ITDiscovery/AVR128PS2Keyboard/README.md

# AVR128PS2Keyboard
This project started as a way to attach a USB Keyboard to a retro computer, the ZX-81. The schematic and board will
accomodate most any retro PC that uses a matrix. It has the ability for both Shift, CTRL, ALT and one other "function key". The board is an extension of the AVR128DB28 Breakout board, so I've included the ability to get at all the ports this device has. This board was not designed to have the fab part out the board for you. I could have done a surface mount board that would be pretty tiny if that were the case, but there's no demand for it. I see this board to assist in troubleshooting, and for demos and museums to extend functionality to users without risking the original keyboard. I have had difficulty in finding keyboards that work with the PS2Keyboard library also.

Design Goals:
1. USB to ZX-81 (done)
1. USB to ZX Spectrum (or Harlequin) (done)
1. USB to Dragon (done on CoCo2)
1. USB to Color Computer 2/3 (done on CoCo2)
1. USB to Model 1/2/3/4/4P/16/6000
1. USB to Commodore VIC20 (done) /C64/PET
1. Classic MacIntosh (M0110 keyboard) via the J9 Connector, and Mouse via J6 Connector. (https://github.com/altercation/tmk_firrmware_hhkb_teensy2/blob/master/protocol/m0110.c) -Done: Needs more work, and I need to correct some issues with my MacClassicPlus 1Mb. This code base will be standalone...how this old Mac handles keys is different from the other retro computers.
1. Have it so that you can select or change on the fly which system you are emulating (done)
1. Have it store a default emulation in EEPROM (done)
1. Provide the ability to do a reset/restore (Using 4Z gate, Pin 7 and 8 on H6). (done)
1. Have it display via keyboard led which emulation it's doing (keyboard.setLEDs seems to be broken, next board can have LEDs added)
1. Provide a serial connection or a Composite TV, so a quicky dumb terminal (combines a couple of projects)
1. Move the lookup tables to Flash (PROGMEM done)

I didn't need to re-write the PS2Advanced Library. After a couple of iterations of DXCore updates, it started working. A guess is that it was a problem with attachInterupt...which if you change the setting of, the library doesn't work at all.

Here's Ben Eater's description of how the Keyboard works. All that is done via the PSAdvanced library.
https://www.youtube.com/watch?v=7aXbh9VUB3U

Level of knowledge/skills required to complete this project:
- Ordering boards from a PCB Prototype shop (I use JCLPCB, so this is a shout out to them.)
- The code is written for Arudino and requires the DXCore library (https://github.com/SpenceKonde/DxCore). You must understand how to program Arduinos, how to add libraries (PS2Advanced Libary is at https://github.com/techpaul/PS2KeyAdvanced) and boards. This is a two step process, you must use the UDPI port to load the bootloader and then the Serial Port to load the code via an FTDI connector.
- Soldering level is moderate. The AVR (which is a surface mount component) is not difficult, it just takes a bit of practice, use flux and small diameter solder. This doesn't use the through hole AVR because those are made of unobtainium. I've recently changed the Gerber on the board to show the values of the parts instead of the part numbers, and am including a BOM from Digikey below. 
- Understanding of the system your adding this wedge to. 

Quick notes:
- 5 boards is 8.50....(presuming it ships, I just combined this with another order and got 5 boards for 2 dollars).
- Maybe $15 for the rest of the components. You'll probably want to just build out all 5. The AVR128DB28 is $1.5 and the logic chips are $0.70 apiece, some resistors and caps. If you don't have anything, buy assortments from Amazon, except for C3. The USB connector is also pricey.
- Never tie the 5v of your target computer and use the FTDI connector at the same time.

Specific support for the various lines have been broken out:
- [Sinclair](https://github.com/ITDiscovery/AVR128PS2Keyboard/blob/main/Sinclair.md) full support of the ZX-80/81 and the Spectrum.
- [Tandy/RadioShack](https://github.com/ITDiscovery/AVR128PS2Keyboard/blob/main/TRS.md) untested code for the Color Computer and Model 3.
- [Commodore](https://github.com/ITDiscovery/AVR128PS2Keyboard/blob/main/Commodore.md) untested code for the C64, and VIC20.

Mux Code is driven by the follwing:

| Connection | Bits  7/6 | Bits 5/4/3 | Bits 2/1/0 |
| - | - | - | - |
| H3-1 | XX | XXX | 000 | 
| H3-2 | XX | XXX | 001 | 
| H3-3 | XX | XXX | 010 | 
| H3-4 | XX | XXX | 011 | 
| H3-5 | XX | XXX | 100 | 
| H3-6 | XX | XXX | 101 | 
| H3-7 | XX | XXX | 110 | 
| H3-8 | XX | XXX | 111 | 
| H4-1 | XX | 000 | XXX | 
| H4-2 | XX | 001 | XXX | 
| H4-3 | XX | 010 | XXX | 
| H4-4 | XX | 011 | XXX | 
| H4-5 | XX | 100 | XXX | 
| H4-6 | XX | 101 | XXX | 
| H4-7 | XX | 110 | XXX | 
| H4-8 | XX | 111 | XXX | 
| No-Shift| 00 | XXX | XXX |
| H6-1/2 | 01 | XXX | XXX |
| H6-3/4 | 10 | XXX | XXX |
| H6-5/6 | 11 | XXX | XXX |

A reset or other switched line (Restore on Commodore for instance) can be
connected to pins H6-7 and H6-8 where the code will perform make contact for 100mSec
when the Pause/Break (Code 6) is typed. A handy ground pin at H5-1 can be used to with a
dropping resistor to H6-8 for a nice reset button.

Connection to the Mac Classic (This is a separate code base):
1. J9-1(Gnd) to H5-1 
1. J9-2(Clk) to H5-4
1. J9-3(Data) to H5-3
1. J9-4(+5v) to H5-2 (Don't populate R4 or R5)
1. J6-1(Gnd) H7-1
1. J6-2(+5V) H7-2
1. J6-3 N/C
1. J6-4(X2) H7-3
1. J6-5(X1) H7-4
1. J6-6 N/C
1. J6-7(SW-) to U4-12
1. J6-8(Y2) to H7-5
1. J6-9(Y1) to H7-6

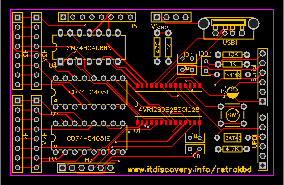
[picture p1: PCB_Retro-Keyboard-from-USB.png]
Board


Bill of Materials (see https://www.digikey.com/en/mylists/list/SCZP9ZUCUN):

- H3A,H4A,H6,H3,H4: HDR-TH_8P-P2.54
- H7:	HDR-TH_6P-P2.54
- U1: AVR128DB28SOIC28
- U2,U3: CD74HCT4051E
- U4: SN74HCT4066N
- C1,C5: 	1uF Capacitor (noise filter)
- C2,C6:  10nF (0.01uF) Capacitor
- C7: 100nf (.1uF) Capacitor
- C3: 4.7uF Electorlytic Capacitor
- D1,D2: 1N4148 Diode (D2 as a BAT43 schotky will work better in some UPDI cases).
- H1,H2: HDR-TH_6P-P2.54
- Optional H5: HDR-TH_4P-P2.54
- R1: 10K 1/4W
- R2: 4.7K 1/4W
- Optional R4: 470 1/4W
- Optional R5: 1K 1/4W
- R6: 1K
- SW1: Button-6x6x6mm
- USB1: USB-A-TH_USB-M-18
