ITDiscovery/AVR128PS2Keyboard/TRS.md

# TRS (Tandy Radio Shack) Color Computer 1,2,3 and Model 1,2,3,4,4P,12,6000 (Untested)
This file contains the connection and keyboard info for the Color Computer 2/3 and Model 3. This code has not been tested.

## Color Computer 2/3
The CoCo3 adds ALT, CTRL for more keymapping, and an F1 and F2 key. It's likely the CoCo3 Keymap will work on a CoCo2.

### Connections
Connect on the board:
1. H4A-8 to H6-1 (Shift)
1. H3A-7 to H6-2
1. H6-2 to H6-3 (CTRL)
1. H4A-5 to H6-4
1. H6-3 to H6-5 (ALT)
1. H4A-4 to H6-6

Connect the board to the Color Computer 2:
1. H7-5 to +5V
1. H7-6 to Gnd
1. H3-1 to J5-1 (R1/Pin 2/PA0)
1. H3-2 to J5-2 (R2/Pin 3/PA1)
1. H3-3 to J5-4 (R3/Pin 4/PA2)
1. H3-4 to J5-5 (R4/Pin 5/PA3)
1. H3-5 to J5-6 (R5/Pin 6/PA4)
1. H3-6 to J5-7 (R6/Pin 7/PA5)
1. H3-7 to J5-8 (R7/Pin 8/PA6)
1. H4-1 to J5-9 (C9/Pin 9/PB0)
1. H4-2 to J5-10 (C10/Pin 10/PB1)
1. H4-3 to J5-11 (C11/Pin 11/PB2)
1. H4-4 to J5-12 (C12/Pin 12/PB3)
1. H4-5 to J5-13 (C13/Pin 13/PB4)
1. H4-6 to J5-14 (C14/Pin 14/PB5)
1. H4-7 to J5-15 (C15/Pin 15/PB6)
1. H4-8 to J5-16 (C16/Pin 16/PB7)

Connect the board to the Dragon64:
1. H7-5 to +5V
1. H7-6 to PL1-3 (Gnd)
1. H3-1 to PL1-4 (KR2)
1. H3-2 to PL1-5 (KR3)
1. H3-3 to PL1-6 (KR4)
1. H3-4 to PL1-7 (KR5)
1. H3-5 to PL1-1 (KR0)
1. H3-6 to PL1-1 (KR1)
1. H3-7 to PL1-8 (KR6)
1. H4-1 to PL1-9 (KC0) 
1. H4-2 to PL1-10 (KC1)
1. H4-3 to PL1-11 (KC2)
1. H4-4 to PL1-12 (KC3)
1. H4-5 to PL1-13 (KC4)
1. H4-6 to PL1-14 (KC5)
1. H4-7 to PL1-15 (KC6)
1. H4-8 to PL1-16 (KC7)

**Note: PA7 goes to the DAC (U3)

### Keychart

| Key | 1 | 2 | 3 | 4 | 5 | 6 | 7 | 8 | 9 | 0 |
| - | - | - | - | - | - | - | - | - | - | - |
| USB Code| 49 | 50 | 51 | 52 | 53 | 54 | 55 | 56 | 57 | 48 | 
| Row/Col | R5C10 | R5C11 | R5C12 | R5C13 | R5C14 | R5C15 | R5C16 | R6C9 | R6C10 | R5C9 |
| Mux Code| B001100 | B010100 | B011100 | B100100 | B101100 | B110100 | B111100 | B000101 | B001101 | B000100 |

| Key | Q | W | E | R | T | Y | U | I | O | P |
| - | - | - | - | - | - | - | - | - | - | - |
| USB Code| 81 | 87 | 69 | 82 | 84 | 89 | 85 | 73 | 79 | 80 | 
| Row/Col | R3C10 | R3C16 | R1C14  | R3C11 | R3C13 | R4C10 | R3C14 | R2C10 | R2C16 | R3C9 |
| Mux Code| B001010 | B111010 | B101000| B010010 | B100010 | B001011 | B101010 | B001001 | B111001 | B000010 |

| Key | A | S | D | F | G | H | J | K | L | ENTER |
| - | - | - | - | - | - | - | - | - | - | - |
| USB Code| 65 | 83 | 68 | 70 | 71 | 72 | 74 | 75 | 76 | 286 | 
| Row/Col | R1C10 | R3C12 | R1C13 | R1C15 | R1C16 | R2C9 | R2C11 | R2C12 | R2C13 | R7C9 |
| Mux Code| B001000 | B011010 | B100000 | B110000 | B111000 | B000001 | B010001 | B011001 | B100001 | B000110 |

| Key | Z | X | C | V | B | N | M | . | SPACE | @ |
| - | - | - | - | - | - | - | - | - | - | - |
| USB Code| 90 | 88 | 67 | 86 | 66 | 78 | 77 | 61 | 287 | 16434 |
| Row/Col | R4C11 | R4C9 | R1C12 | R3C15 | R1C11 | R2C15 | R2C14 | R6C15 | R4C16 | R1C9 |
| Mux Code| B010011 | B000011 | B011000 | B110010 | B010000 | B110001 | B101001 | B110101 | B111011 | B000000 |

| Key | U-Arrow | D-Arrow | L-Arrow | R-Arrow | : | ; | , | - | . | / | 
| - | - | - | - | - | - | - | - | - | - | - |
| USB Code| 279 | 280 | 277 | 278 | 16475 | 91 | 59 | 60 | 61 | 62 | 
| Row/Col | R4C12 | R4C13 | R4C14 | R4C15 | R6C11 | R6C12 | R6C13 | R6C14 | R6C15 | R6C16 |
| Mux Code| B011011 | B100011 | B101011 | B110011 | B010101 | B011101 | B100101 | B101101 | B110101 | B111101 |

| Key | Clear | Break | ALT | CTRL | F1 | F2 | L - Shift | R - Shift |
| - | - | - | - | - | - | - | - | - |
| USB Code| 284 | 283 |  | 8456 | 16646 | 16647 | 353 | 354 | 16646 | 16647 |
| Row/Col | R7C10 | R7C11 | R7C16 | R7C16 | Shift & R6C11 | Shift & R6C12 | Shift & R6C13 | Shift & R6C14 | Shift & R6C15 | Shift & R6C16 |
| Mux Code| B001110 | B010110 | B111110 | B111110 | B1010101 | B1011101 | B1100101 | B1101101 | B1110101 | B1111101 |

```
  {
    //Color Computer 2,3 - Tabletop = 177
    {2,49,B001100},{2,50,B010100},{2,51,B011100},{2,52,B100100},{2,53,B101100},{2,54,B110100},{2,55,B100111},{2,56,B000101},{2,57,B001101},{2,48,B000100},
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
1. H3-7 to J1-7 (R7/A6)
1. H3-8 to J1-8 (R8/A7)
1. H4-1 to J1-9 (C9)
1. H4-2 to J1-10 (C10)
1. H4-3 to J1-11 (C11)
1. H4-4 to J1-12 (C12)
1. H4-5 to J1-13 (C13)
1. H4-6 to J1-14 (C14)
1. H4-7 to J1-15 (C15)
1. H4-8 to J1-16 (C16)

**Note: PA7 goes to the DAC (U3)

### Keychart

| Key | 1 | 2 | 3 | 4 | 5 | 6 | 7 | 8 | 9 | 0 |
| - | - | - | - | - | - | - | - | - | - | - |
| USB Code| 49 | 50 | 51 | 52 | 53 | 54 | 55 | 56 | 57 | 48 | 
| Row/Col | R5C10 | R5C11 | R5C12 | R5C13 | R5C14 | R5C15 | R5C16  | R6C9 | R6C10 | R5C9 |
| Mux Code| B001100 | B010100 | B011100 | B100100 | B101100 | B110100 | B111100| B000101 | B001101 | B000100 |

| Key | Q | W | E | R | T | Y | U | I | O | P |
| - | - | - | - | - | - | - | - | - | - | - |
| USB Code| 81 | 87 | 69 | 82 | 84 | 89 | 85 | 73 | 79 | 80 | 
| Row/Col | R3C10 | R3C16 | R1C14 | R3C11 | R3C13 | R4C10 | R3C14 | R2C10 | R2C16 | R3C9 |
| Mux Code| B001010 | B111010 | B101000 | B010010 | B100010 | B001011 | B101010 | B001001 | B111001 | B000010 |

| Key | A | S | D | F | G | H | J | K | L | ENTER |
| - | - | - | - | - | - | - | - | - | - | - |
| USB Code| 65 | 83 | 68 | 70 | 71 | 72 | 74 | 75 | 76 | 286 | 
| Row/Col | R1C10 | R3C12 | R1C13 | R1C15 | R1C16 | R2C9 | R2C11 | R2C12 | R2C13 | R7C9 |
| Mux Code| B001000 | B011010 | B100000 | B110000 | B111000 | B000001 | B010001 | B011001 | B100001 | B000110 |

| Key | Z | X | C | V | B | N | M | . | SPACE | @ |
| - | - | - | - | - | - | - | - | - | - | - |
| USB Code| 90 | 88 | 67 | 86 | 66 | 78 | 77 | 61 | 287 | 16434 |
| Row/Col | R4C11 | R4C9 | R1C12 | R3C15 | R1C11 | R2C15 | R2C14 | R6C16 | R7C16 | R1C9 |
| Mux Code| B010011 | B000011 | B011000 | B110010 | B010111 | B110001 | B101001 | B111101 | B111110 | B000000 |

| Key | U-Arrow | D-Arrow | L-Arrow | R-Arrow | : | ; | , | - | . | / | 
| - | - | - | - | - | - | - | - | - | - | - |
| USB Code| 279 | 280 | 277 | 278 | 16475 | 91 | 59 | 60 | 61 | 62 | 
| Row/Col | R7C12 | R7C13 | R7C14 | R7C15 | R6C11 | R6C12 | R6C13 | R6C14 | R6C15 | R6C16 |
| Mux Code| B011110 | B100110 | B101110 | B110110 | B010101 | B011101 | B100101 | B101101 | B110101 | B111101 |

| Key | Clear | Break | L-Shift | R-Shift | * | + | < | = | > | ? | 
| - | - | - | - | - | - | - | - | - | - | - |
| USB Code| 284 | 283 | 16646 | 16647 | 16440 | 16479 | 16443 | 95 | 16445 | 16446 |
| Row/Col | R7C10 | R7C11 | R8C9 | R8C10 | S + R6C11 | S + R6C12 | S+ R6C13 | S + R6C14 | S + R6C15 | S + R6C16 |
| Mux Code| B110001 | B010110 | B000111 | B001111 | B1010101  | B1011101  | B1100101 | B1101101  | B1110101  | B1111101 |

```
{
    //TRS-80 Model 3,4,4P Tabletop = 100
    {4,49,B001100},{4,50,B010100},{4,51,B011100},{4,52,B100100},{4,53,B101100},{4,54,B110100},{4,55,B100111},{4,56,B000101},{4,57,B001101},{4,48,B000100},
    {4,81,B001010},{4,87,B111010},{4,69,B101000},{4,82,B010010},{4,84,B100010},{4,89,B001011},{4,85,B101010},{4,73,B001001},{4,79,B111001},{4,80,B111010},
    {4,65,B001000},{4,83,B011010},{4,68,B100000},{4,70,B110000},{4,71,B111000},{4,72,B000001},{4,74,B010001},{4,75,B011001},{4,76,B100001},{4,286,B000110},
    {4,90,B010011},{4,88,B000011},{4,67,B011000},{4,86,B110010},{4,66,B010000},{4,78,B110001},{4,77,B101001},{4,61,B110101},{4,287,B111011},{4,16343,B000000}, 

       //TRS-80 Model 3,4,4P Shifted
    {4,16384+49,B1001100},{4,16384+50,B1010100},{4,16384+51,B1011100},{4,16384+52,B1100100},{4,16384+53,B1101100},{4,16384+54,B1110100},{4,16384+55,B1100111},{4,16384+56,B1000101},{4,16384+57,B1001101},{4,16384+48,B1000100},
    {4,16384+81,B1001010},{4,16384+87,B1111010},{4,16384+69,B1101000},{4,16384+82,B1010010},{4,16384+84,B1100010},{4,16384+89,B1001011},{4,16384+85,B1101010},{4,16384+73,B1001001},{4,16384+79,B1111001},{4,16384+80,B1111010},
    {4,16384+65,B1001000},{4,16384+83,B1011010},{4,16384+68,B1100000},{4,16384+70,B1110000},{4,16384+71,B1111000},{4,16384+72,B1000001},{4,16384+74,B1010001},{4,16384+75,B1011001},{4,16384+76,B1100001},{4,16384+286,B1000110},
    {4,16384+90,B1010011},{4,16384+88,B1000011},{4,16384+67,B1011000},{4,16384+86,B1110010},{4,16384+66,B1010000},{4,16384+78,B1110001},{4,16384+77,B1101001},{4,16384+61,B1110101},{4,16384+287,B1111011},{4,16384+16343,B1000000}, 
   
    //TRS-80 Model 3,4,4P Special Chars
    {4,279,B011110},{4,280,B100110},{4,277,B101110},{4,278,B110110},{4,16475,B010101},{4,91,B011101},{4,59,B100101},{4,60,B101101},{4,61,B110101},{4,62,B111101},
    {4,284,B110001},{4,283,B010110},{4,16646,B000111},{4,16647,B001111},{4,16440,B1010101},{4,16479,B1011101},{4,17443,B1100101},{4,95,B1101101},{4,16445,B111011},{4,16446,B1111101}
}
```
