ITDiscovery/AVR128PS2Keyboard/a.bmp

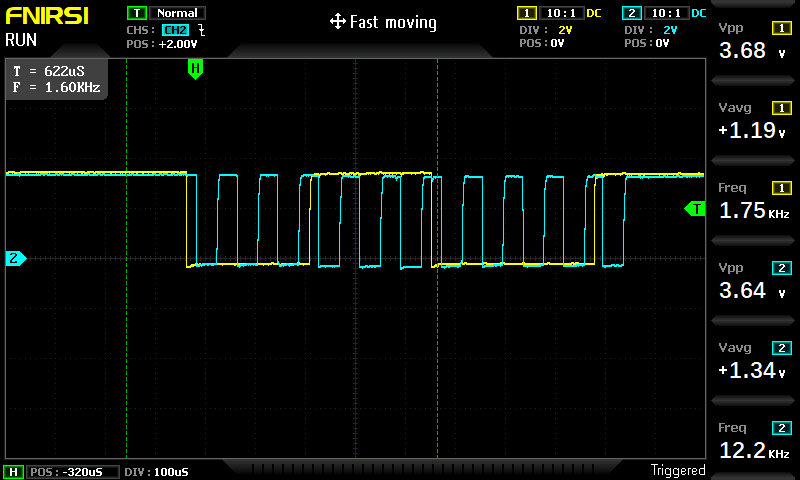
a.bmp
