ITDiscovery/AVR128PS2Keyboard/b.bmp

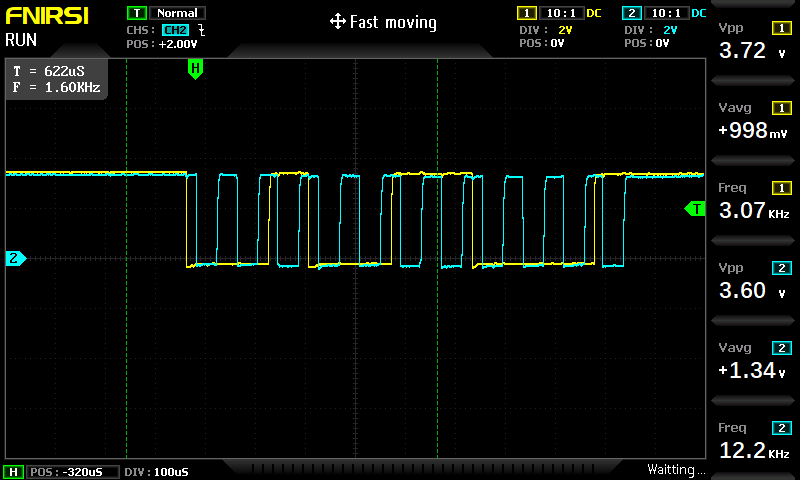
b.bmp
