ITDiscovery/AVR128PS2Keyboard/c.bmp

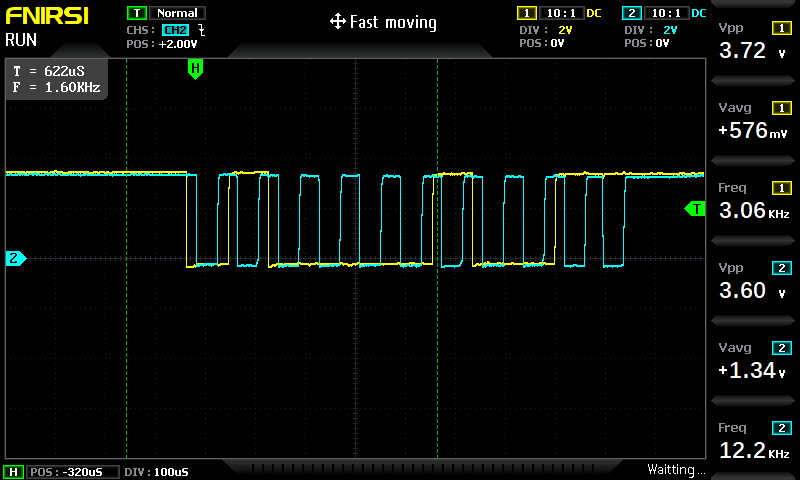
c.bmp
