ITDiscovery/AVR128PS2Keyboard/d.bmp

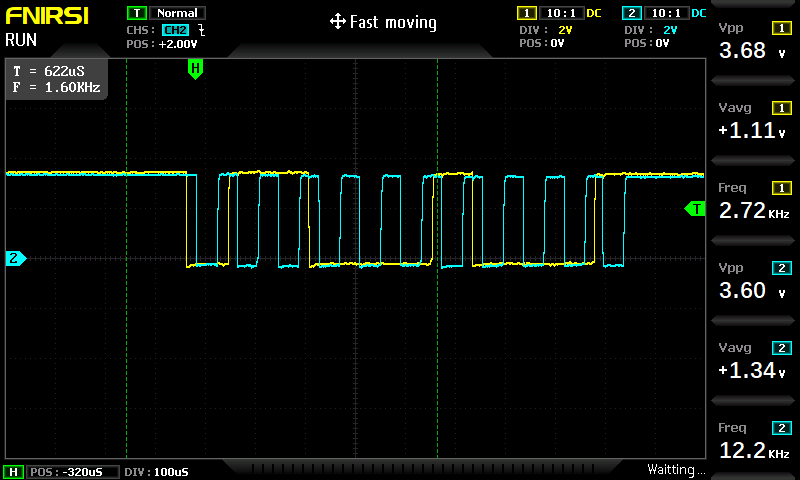
d.bmp
