ITDiscovery/AVR128PS2Keyboard/e.bmp

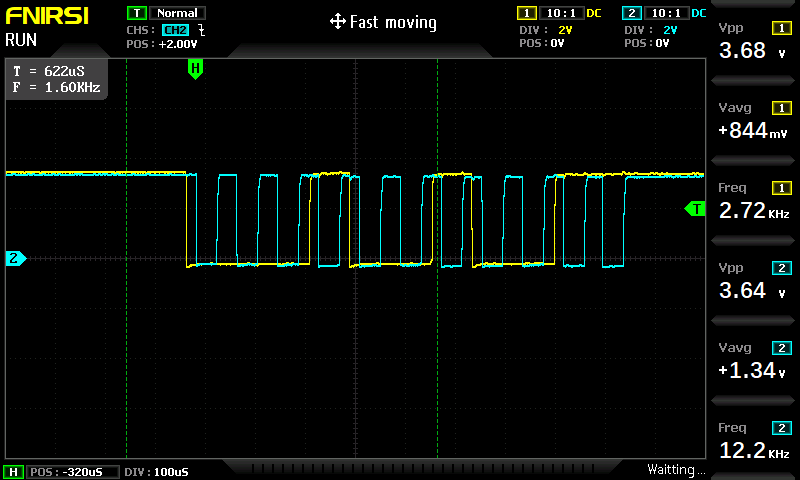
e.bmp
