ITDiscovery/AVR128PS2Keyboard/Schematic_USBtoRetroKeyboard-TH_v1_1.pdf

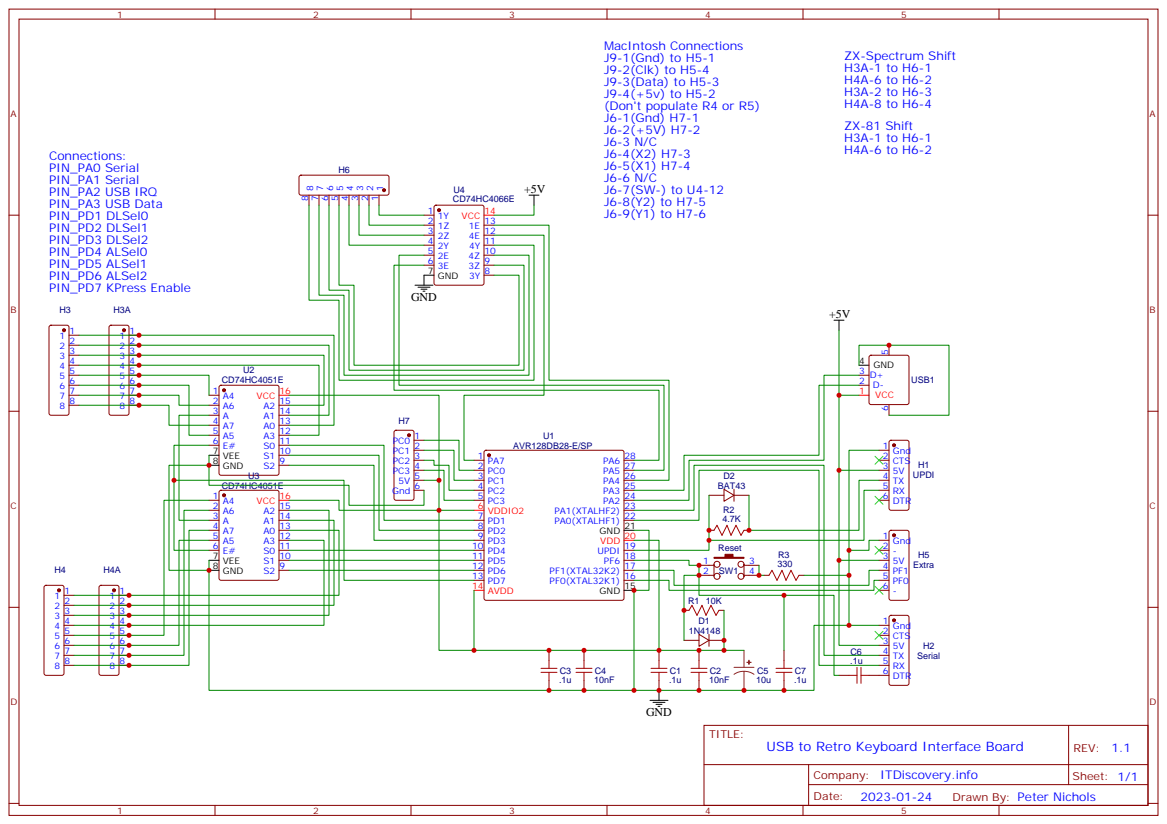
[picture p7: page 1]

Drawn By: Peter Nichols
