ITDiscovery/AVR128PS2Keyboard/BCardAVR128DB28.pdf

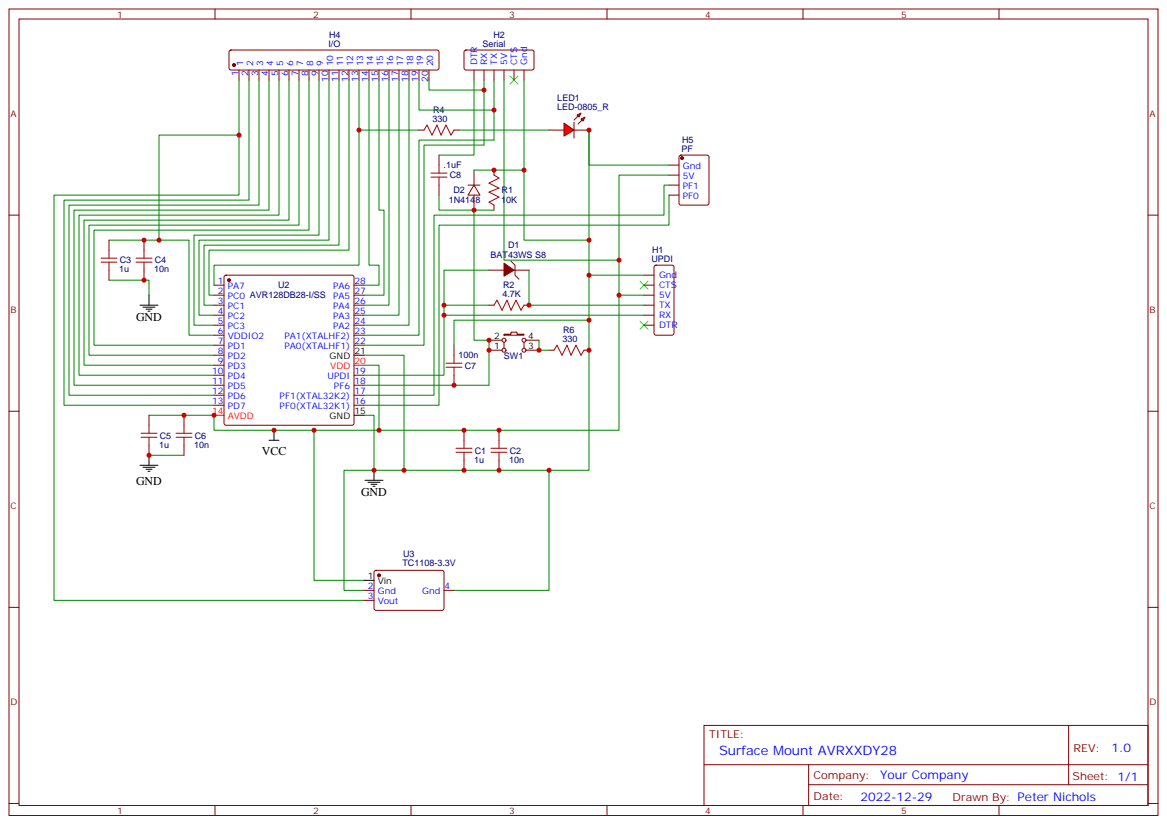
[picture p8: page 1]

Drawn By: Peter Nichols
