ITDiscovery/AVR128PS2Keyboard/Schematic_USBtoRetroKeyboard-TH-v1.0.pdf

# USB1EP

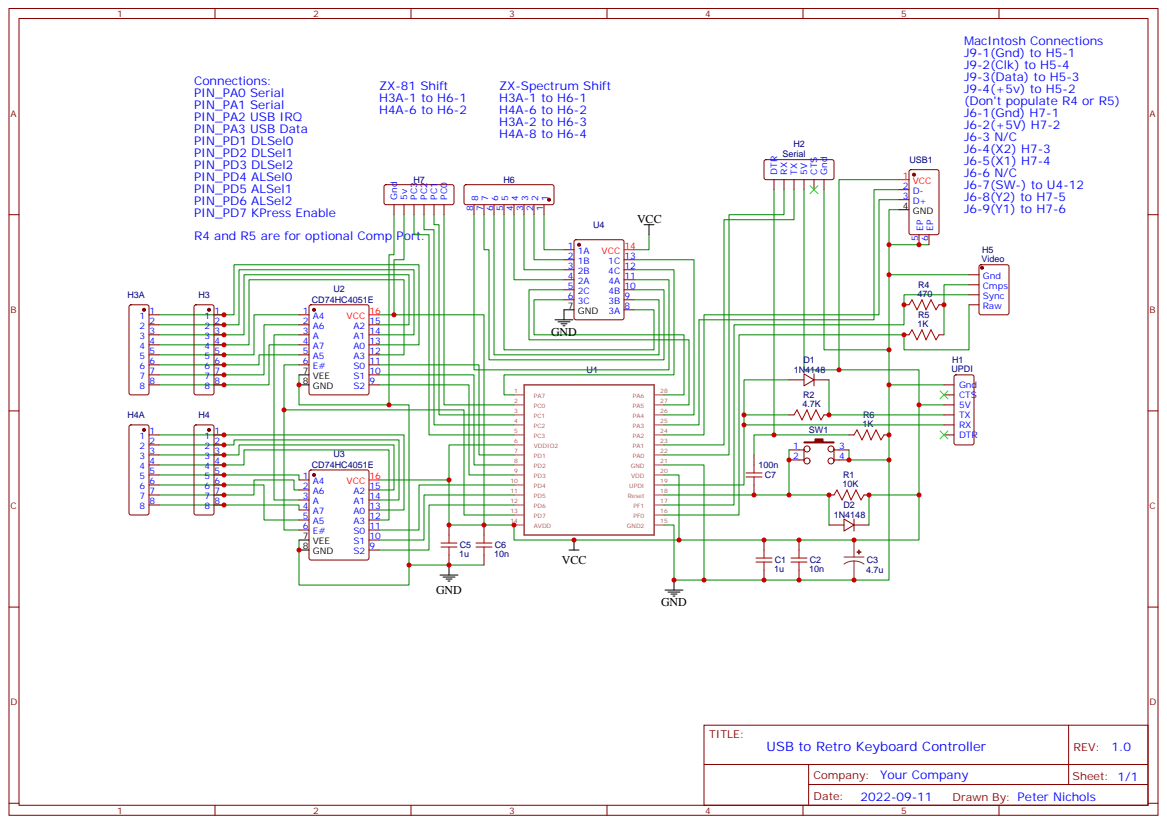
[picture p9: page 1]

R4 and R5 are for optional Comp Port.

Drawn By: Peter Nichols
