ITDiscovery/AVR128PS2Keyboard/AVR128DB28-USBKeyboard-Rev4/AVR128DB28-USBKeyboard-Rev4.ino

/*  Business Card USB to ZX-81 Keyboard
    via PS2KeyAdvanced library Written by Paul Carpenter, PC Services <sales@pcserviceselectronics.co.uk>

   The connector to mate with USB keyboard is a 4 pin USB Type A
   USB Pins to signal to AVR128DB28
    1   +5V
    2   KBD Clock PIN_PA2
    3   KBD Data  PIN_PA3
    4   Gnd
   
  Read method Returns an UNSIGNED INT containing
        Make/Break status
        Caps status
        Shift, CTRL, ALT, ALT GR, GUI keys
        Flag for function key not a displayable/printable character
        8 bit key code

  Code Ranges (bottom byte of unsigned int)
        0       invalid/error
        1-1F    Functions (Caps, Shift, ALT, Enter, DEL... )
        1A-1F   Functions with ASCII control code
                    (DEL, BS, TAB, ESC, ENTER, SPACE)
        20-61   Printable characters noting
                    0-9 = 0x30 to 0x39 as ASCII
                    A to Z = 0x41 to 0x5A as upper case ASCII type codes
                    8B Extra European key
        61-A0   Function keys and other special keys (plus F2 and F1)
                    61-78 F1 to F24
                    79-8A Multimedia
                    8B NOT included
                    8C-8E ACPI power
                    91-A0 and F2 and F1 - Special multilingual
        A8-FF   Keyboard communications commands (note F2 and F1 are special
                codes for special multi-lingual keyboards)

    By using these ranges it is possible to perform detection of any key and do
    easy translation to ASCII/UTF-8 avoiding keys that do not have a valid code.

    Top Byte is 8 bits denoting as follows with defines for bit code

        Define name bit     description
        PS2_BREAK   15      1 = Break key code
                   (MSB)    0 = Make Key code
        PS2_SHIFT   14      1 = Shift key pressed as well (either side)
                            0 = NO shift key
        PS2_CTRL    13      1 = Ctrl key pressed as well (either side)
                            0 = NO Ctrl key
        PS2_CAPS    12      1 = Caps Lock ON
                            0 = Caps lock OFF
        PS2_ALT     11      1 = Left Alt key pressed as well
                            0 = NO Left Alt key
        PS2_ALT_GR  10      1 = Right Alt (Alt GR) key pressed as well
                            0 = NO Right Alt key
        PS2_GUI      9      1 = GUI key pressed as well (either)
                            0 = NO GUI key
        PS2_FUNCTION 8      1 = FUNCTION key non-printable character (plus space, tab, enter)
                            0 = standard character key

  Error Codes
     Most functions return 0 or 0xFFFF as error, other codes to note and
     handle appropriately
        0xAA   keyboard has reset and passed power up tests
               will happen if keyboard plugged in after code start
        0xFC   Keyboard General error or power up fail

  See PS2Keyboard.h file for returned definitions of Keys

  Note defines starting
            PS2_KEY_* are the codes this library returns
            PS2_*     remaining defines for use in higher levels

  To get the key as ASCII/UTF-8 single byte character conversion requires use
  of PS2KeyMap library AS WELL.

*/
#include <EEPROM.h>
#include <PS2KeyAdvanced.h>

/* Keyboard constants  Change to suit your Arduino
   define pins used for data and clock from keyboard */

// Make sure to have attachInterupt=All Pins

// PIN_PA0 Serial
// PIN_PA1 Serial
// PIN_PA2 USB IRQ
// PIN_PA3 USB Data
// PIN_PD1 DLSel0
// PIN_PD2 DLSel1
// PIN_PD3 DLSel2
// PIN_PD4 ALSel0
// PIN_PD5 ALSel1
// PIN_PD6 ALSel2
// PIN_PD7 KPress
// PIN_PA4 Shift
// PIN_PA5 ALT/SymShift
// PIN_PA6 CTRL
// PIN_PA7 Shift4
// PIN_PC0 - 3 at H7-1 to H7-4, early board does not have 5V to VDDIO to make this usable.
// PIN_PF0 to H5-5, early board has resistors for video out, which isn't well supported.
// PIN_PF1 to H5-4

#define DATAPIN PIN_PA3
#define IRQPIN  PIN_PA2
const byte kbdPins[] = {PIN_PD1, PIN_PD2, PIN_PD3, PIN_PD4, PIN_PD5, PIN_PD6, PIN_PA4, PIN_PA5, PIN_PA6, PIN_PA7, PIN_PD7};

uint16_t lookup[6][200][5] = {
//Unshifted ZX81 - Tabletop=89
  {  
  {0,49,B000000},{0,50,B000001},{0,51,B000010},{0,52,B000011},{0,53,B000100},{0,54,B010100},{0,55,B010011},{0,56,B010010},{0,57,B010001},{0,48,B010000},
  {0,81,B001000},{0,87,B001001},{0,69,B001010},{0,82,B001011},{0,84,B001100},{0,89,B100100},{0,85,B100011},{0,73,B100010},{0,79,B100001},{0,80,B100000},
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
    {4,284,B110001},{4,283,B010110},{4,16646,B000111},{4,16647,B001111},{4,16440,B1010101},{4,16479,B1011101},{4,17443,B1100101},{4,95,B1101101},{4,16445,B111011},{4,16446,B1111101}
    }

};

PS2KeyAdvanced keyboard;
byte kbdtmp, tabletop;

void setup( )
{
  // Configure the keyboard library
  keyboard.begin(DATAPIN,IRQPIN);

  for (int d = 0; d < 11; d++)
  {
    pinMode(kbdPins[d], OUTPUT);
    digitalWrite(kbdPins[d], HIGH); //initial LED state
  }
  //Send the Shift Keys Low
  digitalWrite(kbdPins[6],LOW);
  digitalWrite(kbdPins[7],LOW);
  digitalWrite(kbdPins[8],LOW);
  digitalWrite(kbdPins[9],LOW);
  
  //Storing saved default template at EEPROM(0) and size of table at EEPROM(1)
  kbdtmp = EEPROM.read(0);
  tabletop = EEPROM.read(1);
  if (kbdtmp > 4) {
    // Keyboard Template defaults to ZX-81
    kbdtmp = 0;
    // This template has 89 entries
    tabletop = 89;
  }   
  Serial.begin(115200);
  Serial.println( "USB Keyboard Debug Output:" );
  Serial.print("Template ");
  Serial.print(kbdtmp);
  Serial.print(" Entries:");
  Serial.println(tabletop);
  //Setting Keyboard LEDs not working
  //keyboard.setLock(1);
}

void loop( )
{
  if( keyboard.available( ) )
  {
  // read the next key
  uint16_t c = keyboard.read( );

  //Ignore Keyboard break and only look at make
  if (c>0) 
    {
      //F12 Key=364 Code Goes Here
      if (c==364) {
        ChgTmplate();
      }
      if (c==6) {
        RstButton();
      }
      Serial.print("Keycode=");
      Serial.print(c);
      uint16_t e = 0;
      while (lookup[kbdtmp][e][1] != c and e < tabletop) {
        e++;
      }
      Serial.print(" lookup[");
      Serial.print(kbdtmp);
      Serial.print("][");
      Serial.print(e);
      Serial.print("][1] = ");
      if (e < tabletop) {
        Serial.print(lookup[kbdtmp][e][2]);
        Serial.print(" Out:");
        ALDLOutput(lookup[kbdtmp][e][2]);  
      }
      else Serial.println("Not Found");
    }
  }
}

void ALDLOutput(int d) 
{
  for (int q = 0; q < 8; q++)
   {
    if (((d >> q) & 1) == 1) {
      Serial.print("1");
      digitalWrite(kbdPins[q],HIGH);
    }
    else {
      Serial.print("0");
      digitalWrite(kbdPins[q],LOW);
    }
   }     
  Serial.println("");
  digitalWrite(kbdPins[10],LOW);
  delay(200);
  digitalWrite(kbdPins[6],LOW);
  digitalWrite(kbdPins[7],LOW);
  //digitalWrite(kbdPins[8],LOW);
  //digitalWrite(kbdPins[9],LOW);
  digitalWrite(kbdPins[10],HIGH);
}

void RstButton()
{
  digitalWrite(kbdPins[9],HIGH);
  delay(100);
  digitalWrite(kbdPins[9],LOW);  
}

void ChgTmplate()
{
  switch (kbdtmp) {
    case 0:
      //Switch to Spectrum
      kbdtmp=1;
      tabletop=172;
      EEPROM.write(0,1);
      EEPROM.write(1,172);
      break;
    case 1:
      //Switch to CoCo2,3
      kbdtmp=2;
      tabletop=177;
      EEPROM.write(0,2);
      EEPROM.write(1,177);
      break;
    case 2:
      //Switch to VIC20
      kbdtmp=3;
      tabletop=149;
      EEPROM.write(0,3);
      EEPROM.write(1,149);
      break;
    case 3: 
      //Switch to Model 3,4
      kbdtmp=4;
      tabletop=100;
      EEPROM.write(0,4);
      EEPROM.write(1,100);
      break;
    default:
      //Switch to ZX-80,81
      kbdtmp=0;
      tabletop=89;
      EEPROM.write(0,0);
      EEPROM.write(1,89);     
  }
  Serial.print("Changed to template ");
  Serial.println(kbdtmp);
}
