ITDiscovery/AVR128PS2Keyboard/(commit log)

2022-04-21 Create PA2PinInteruptSample.ino
    This sample shows a working interrupt firing on the falling edge of input to PIN_PA2.
2022-09-25 Added circuit to allow for 4 additional controls
    Adds Shift, CTRL, ALT, and 1 more, and ports out PC0-3
2022-10-01 Verified against new PCB
    Added extra key mappings
2022-12-26 Business Card Schematic
2023-01-01 Corrected crappy reset circuit
2023-01-25 Added through-hole v1.1 board
2023-01-26 Updated schematics for v1.1
    [BOM_PCB_USBtoRetroKeyboard-SM_v1_1.csv]
2025-05-16 Fix P and 7 Key on CoCo
    [AVR128DB28-USBKeyboard-Rev4.ino]
2025-08-30 Just produced Gerber, Pick and Place, and BOM.
    The P&P and BOM may not work. I've suggest having a PCB house produce just the PCB via Gerber, then part it out yourself.
    [BOM_Retro-Keyboard-from-USB_2025-08-29.csv, PickAndPlace_PCB_Retro-Keyboard-from-USB_2025-08-29.csv]
2025-09-25 Updated Gerber and PNG
    Reflects only silkscreen change.
2025-09-25 Update README.md - added requirements
    Added reference to knowledge level needed to complete the project and BOM
